ErangaRanasinghe/Solar_LoRa_SHT41_Sensor/govi_v3_SHT41_sensor_kicad.kicad_pcb

## KiCad design govi_v3_SHT41_sensor_kicad.kicad_pcb (2025-12-08)

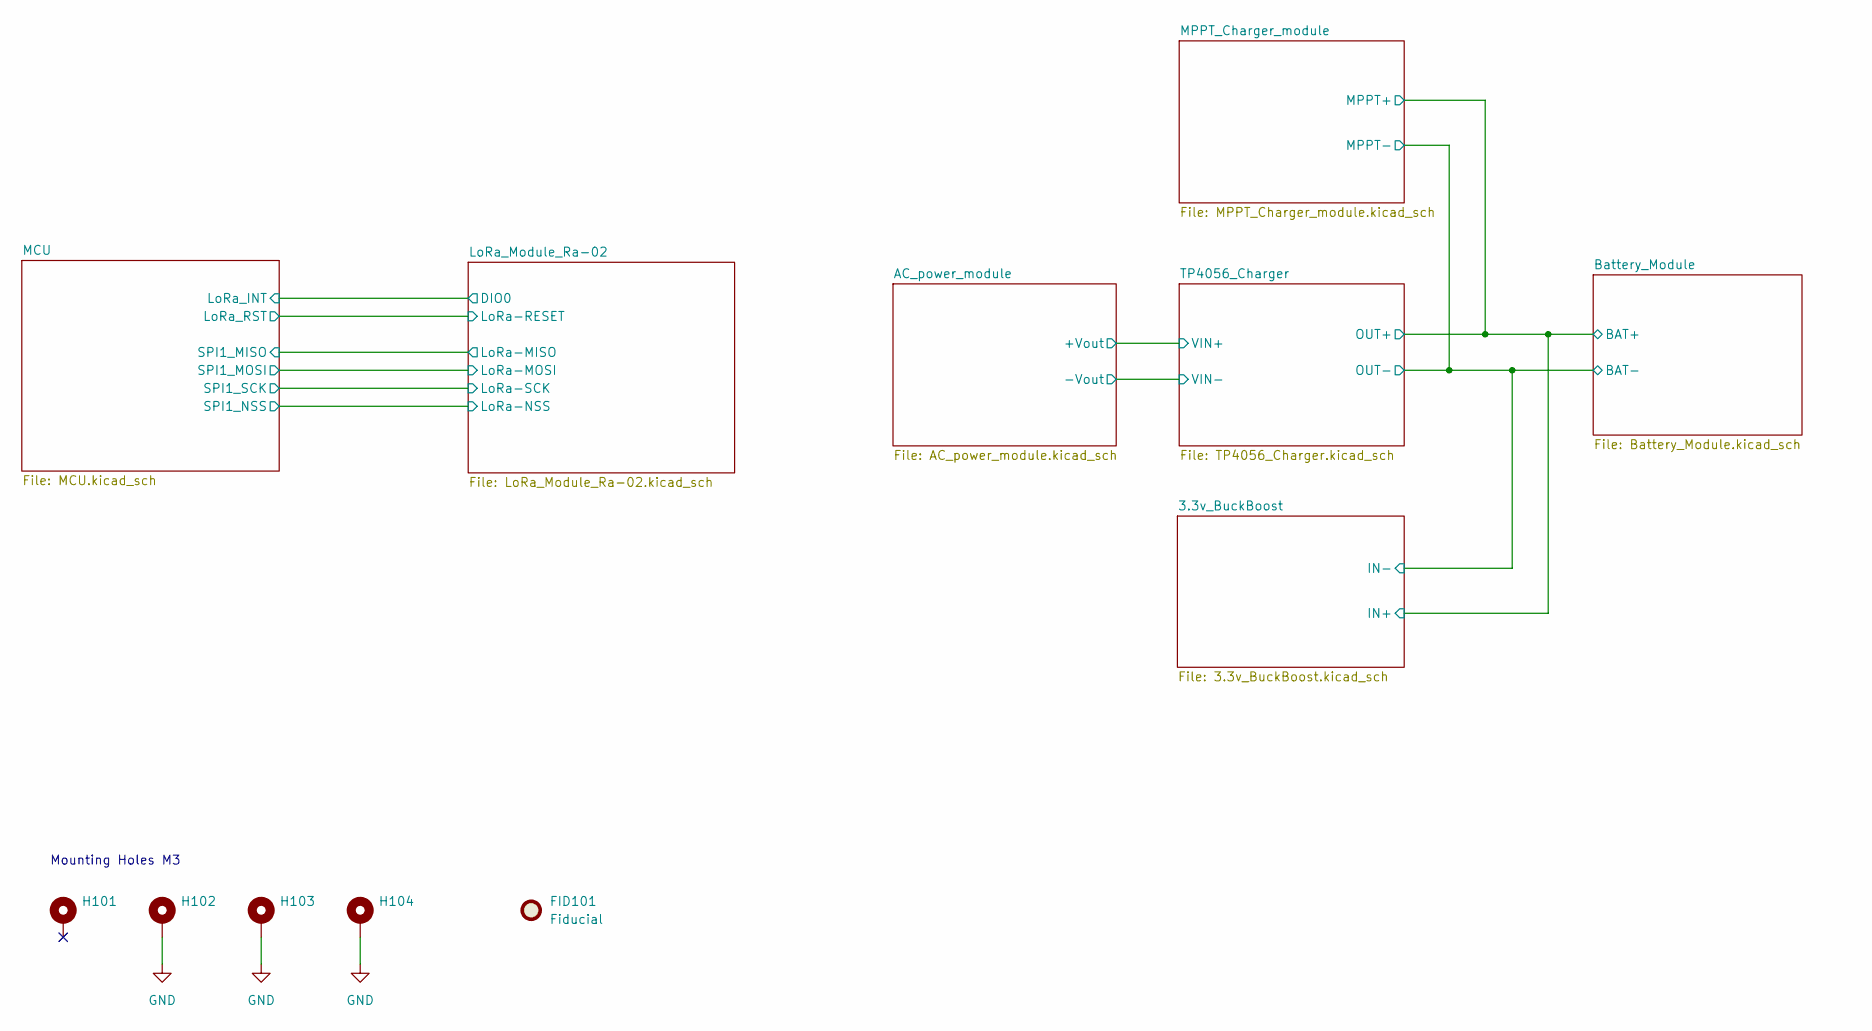
[picture p1: schematic govi_v3_SHT41_sensor_kicad.kicad_sch]

Parts:
FID101: Fiducial; Fiducial_1mm_Mask3mm
H101, H102, H103, H104: MountingHole_Pad; MountingHole_3.2mm_M3_Pad_TopBottom

Connections:
GND: H102.1, H103.1, H104.1; also elsewhere on the board

Notes on the sheet:
Mounting Holes M3

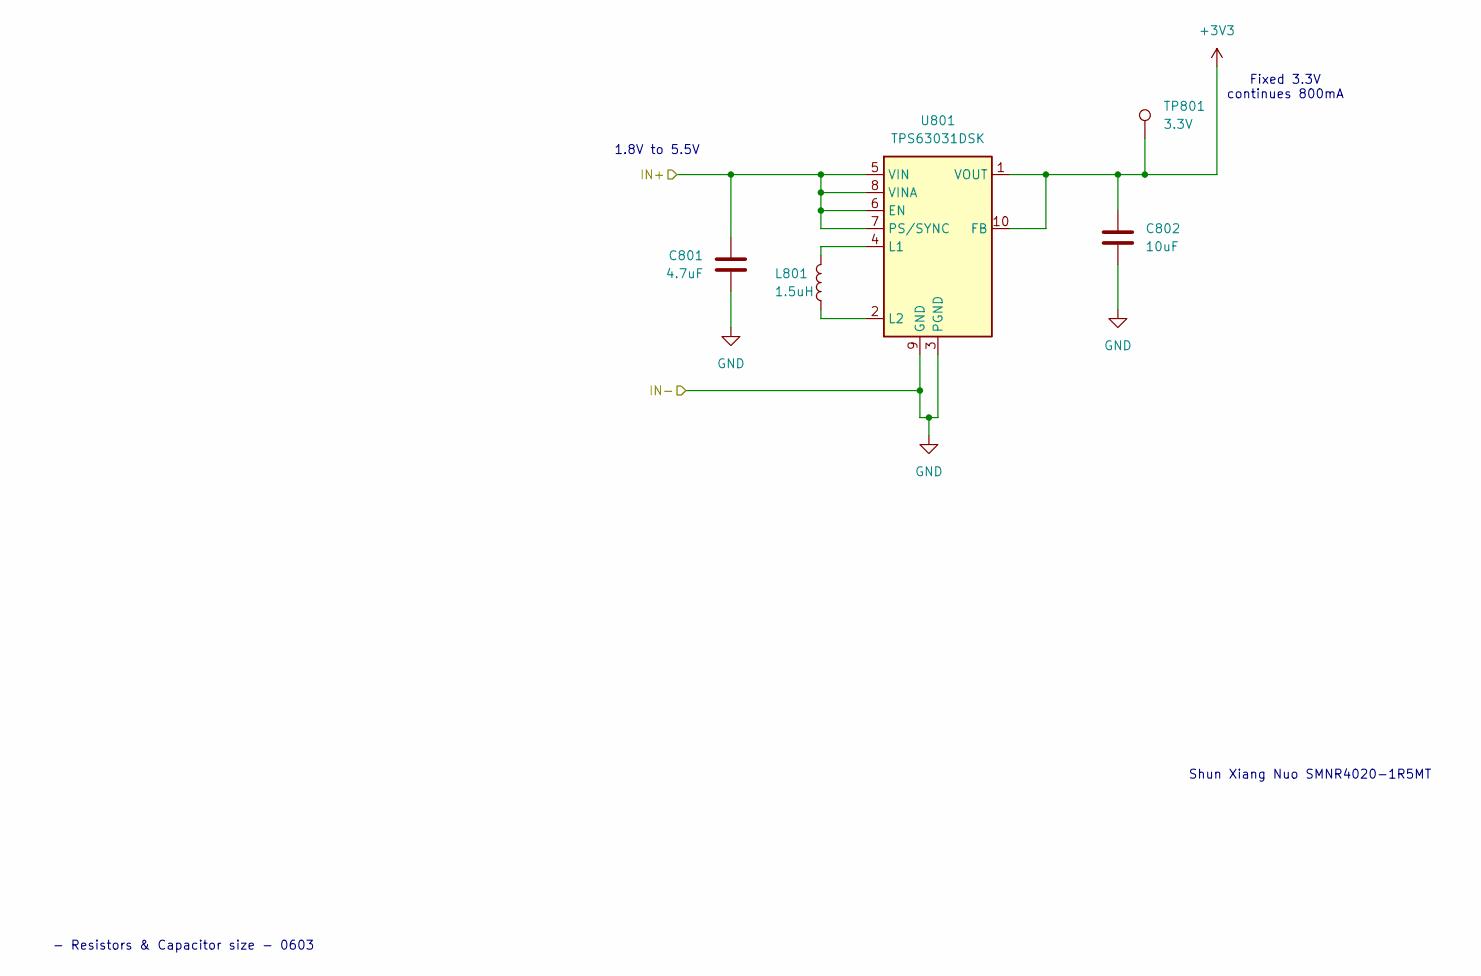
[picture p2: schematic 3.3v_BuckBoost.kicad_sch]

Parts:
C801: 4.7uF; C_0603_1608Metric_Pad1.08x0.95mm_HandSolder
C802: 10uF; C_0603_1608Metric_Pad1.08x0.95mm_HandSolder
L801: 1.5uH; L_Wurth_WE-LQSH-4020
TP801: 3.3V; TestPoint_Pad_D1.0mm
U801: TPS63031DSK; WSON-10-1EP_2.5x2.5mm_P0.5mm_EP1.2x2mm

Connections:
+3V3: C802.1, TP801.1, U801.1 (VOUT), U801.10 (FB); also elsewhere on the board
/3.3v_BuckBoost/IN+: C801.1, U801.5 (VIN), U801.6 (EN), U801.7 (PS/SYNC), U801.8 (VINA); also elsewhere on the board
GND: C801.2, C802.2, U801.3 (PGND), U801.9 (GND), U801.11 (PGND); also elsewhere on the board
unnamed: L801.1, U801.4 (L1)
unnamed: L801.2, U801.2 (L2)

Notes on the sheet:
Shun Xiang Nuo SMNR4020-1R5MT
- Resistors & Capacitor size - 0603
1.8V to 5.5V
Fixed 3.3V continues 800mA

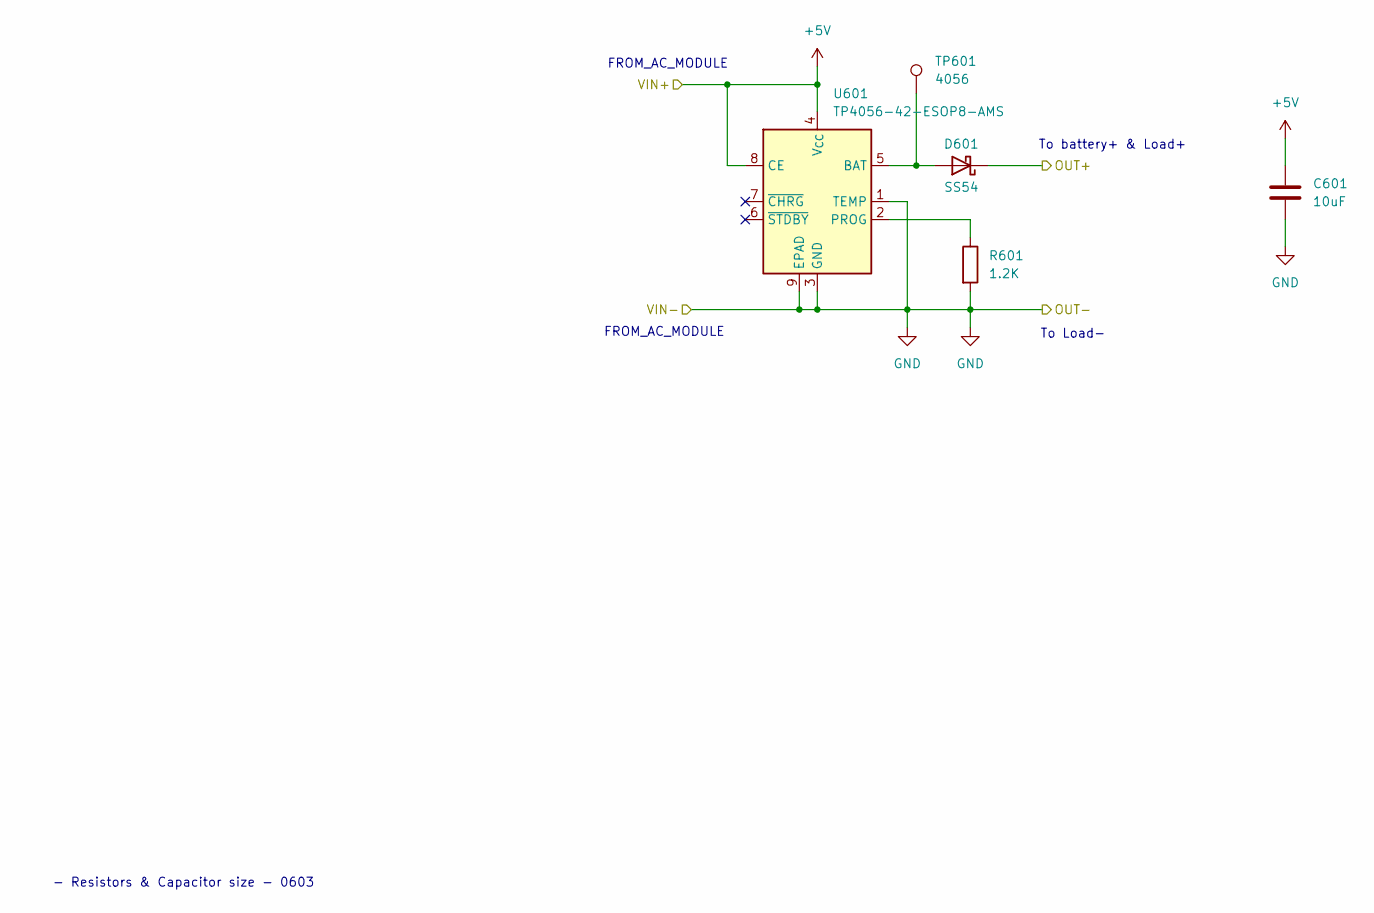
[picture p3: schematic TP4056_Charger.kicad_sch]

Parts:
C601: 10uF; C_0603_1608Metric_Pad1.08x0.95mm_HandSolder
D601: SS54; D_SMA
R601: 1.2K; R_0603_1608Metric_Pad0.98x0.95mm_HandSolder
TP601: 4056; TestPoint_Pad_D1.0mm
U601: TP4056-42-ESOP8-AMS; SOIC-8-1EP_3.9x4.9mm_P1.27mm_EP2.41x3.3mm_ThermalVias

Connections:
+5V: C601.1, U601.4 (V_{CC}), U601.8 (CE); also elsewhere on the board
/3.3v_BuckBoost/IN+: D601.1 (K); also elsewhere on the board
GND: C601.2, R601.2, U601.1 (TEMP), U601.3 (GND), U601.9 (EPAD); also elsewhere on the board
unnamed: D601.2 (A), TP601.1, U601.5 (BAT)
unnamed: R601.1, U601.2 (PROG)

Notes on the sheet:
- Resistors & Capacitor size - 0603
To battery+ & Load+
To Load-
FROM_AC_MODULE

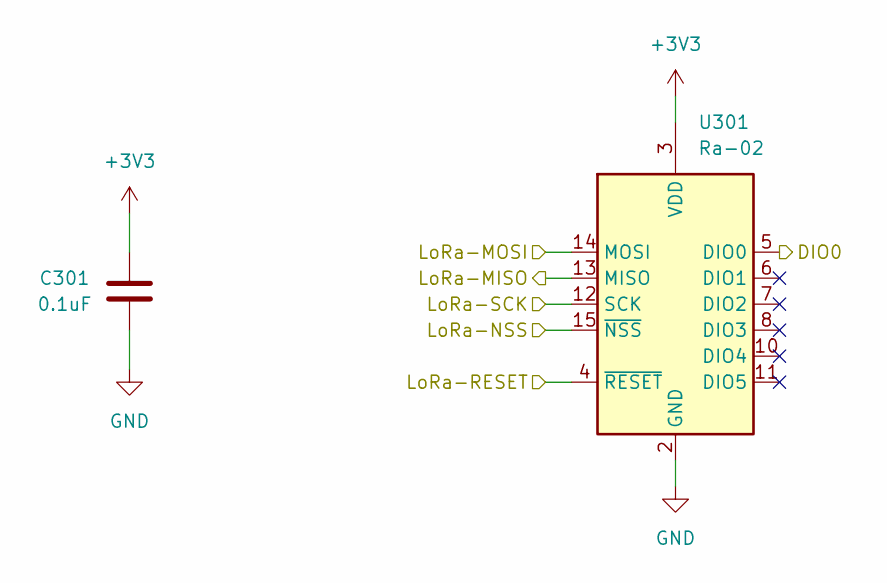
[picture p4: schematic LoRa_Module_Ra-02.kicad_sch]

Parts:
C301: 0.1uF; C_0402_1005Metric_Pad0.74x0.62mm_HandSolder
U301: Ra-02; Ai-Thinker-Ra-01-LoRa

Connections:
+3V3: C301.1, U301.3 (VDD); also elsewhere on the board
/LoRa_Module_Ra-02/LoRa-MISO: U301.13 (MISO); also elsewhere on the board
/LoRa_Module_Ra-02/LoRa-MOSI: U301.14 (MOSI); also elsewhere on the board
/LoRa_Module_Ra-02/LoRa-NSS: U301.15 (~NSS); also elsewhere on the board
/LoRa_Module_Ra-02/LoRa-RESET: U301.4 (~RESET); also elsewhere on the board
/LoRa_Module_Ra-02/LoRa-SCK: U301.12 (SCK); also elsewhere on the board
/MCU/LoRa_INT: U301.5 (DIO0); also elsewhere on the board
GND: C301.2, U301.1 (GND), U301.2 (GND), U301.9 (GND), U301.16 (GND); also elsewhere on the board

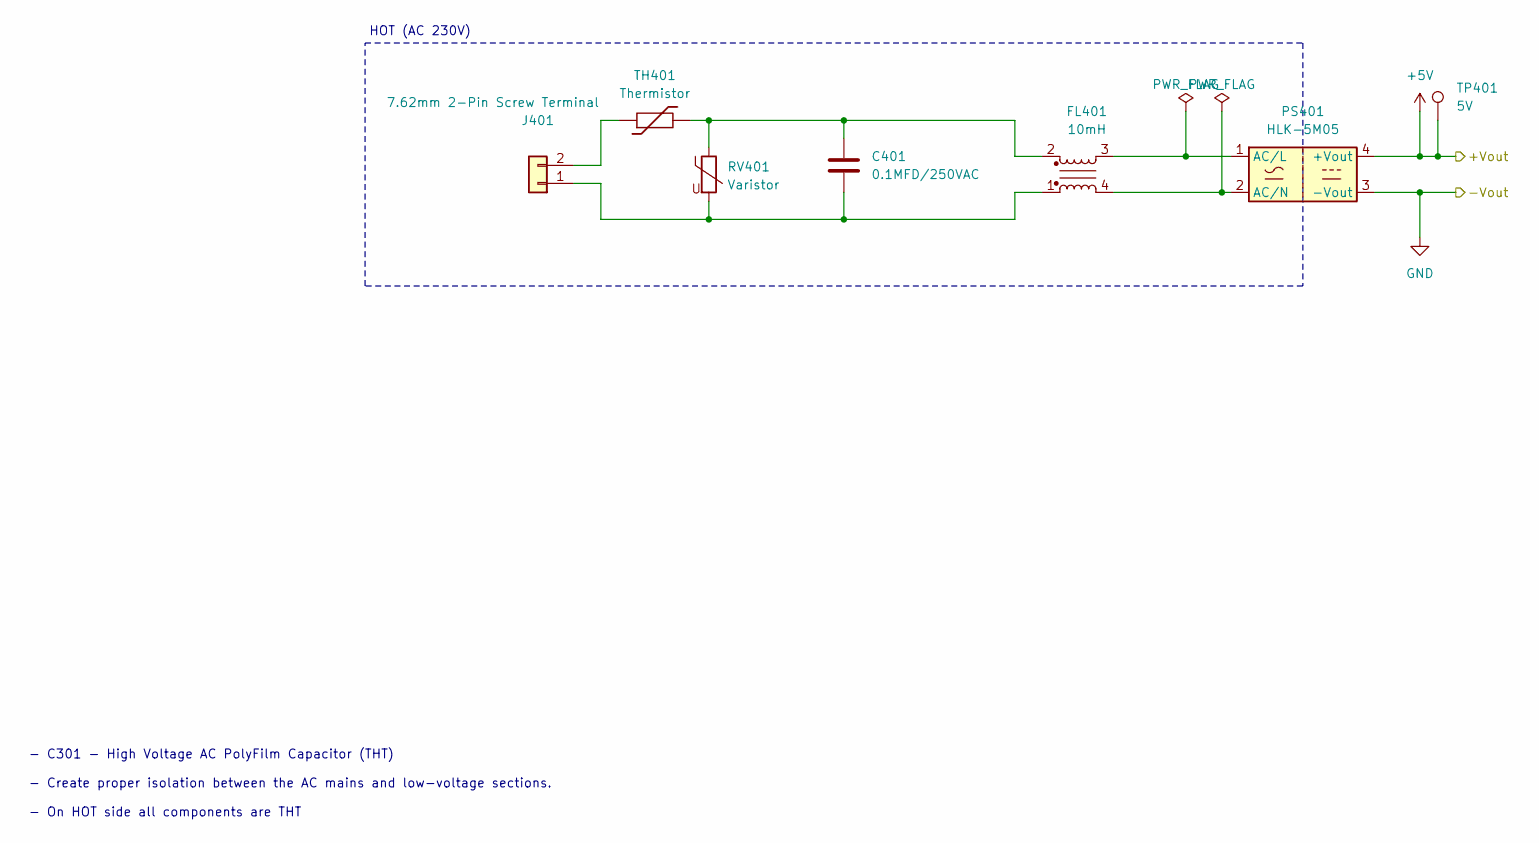
[picture p5: schematic AC_power_module.kicad_sch]

Parts:
C401: 0.1MFD/250VAC; C_Rect_L11.5mm_W5.0mm_P10.00mm_MKT
FL401: 10mH; B82730U3451A020-ferrite-core-inductor
J401: 7.62mm 2-Pin Screw Terminal; P=7.62mm Barrier Terminal Blocks azend
PS401: HLK-5M05; HLK5M05
RV401: Varistor; RV_Disc_D12mm_W5.1mm_P7.5mm
TH401: Thermistor; B57236S0250M000-Thermister
TP401: 5V; TestPoint_Pad_D1.0mm

Connections:
+5V: PS401.4 (+Vout), TP401.1; also elsewhere on the board
GND: PS401.3 (-Vout); also elsewhere on the board
unnamed: C401.1, FL401.2, RV401.1, TH401.2
unnamed: C401.2, FL401.1, J401.1, RV401.2
unnamed: J401.2, TH401.1
unnamed: FL401.3, PS401.1 (AC/L)
unnamed: FL401.4, PS401.2 (AC/N)

Notes on the sheet:
HOT (AC 230V)
- C301 - High Voltage AC PolyFilm Capacitor (THT) - Create proper isolation between the AC mains and low-voltage sections. - On HOT side all components are THT

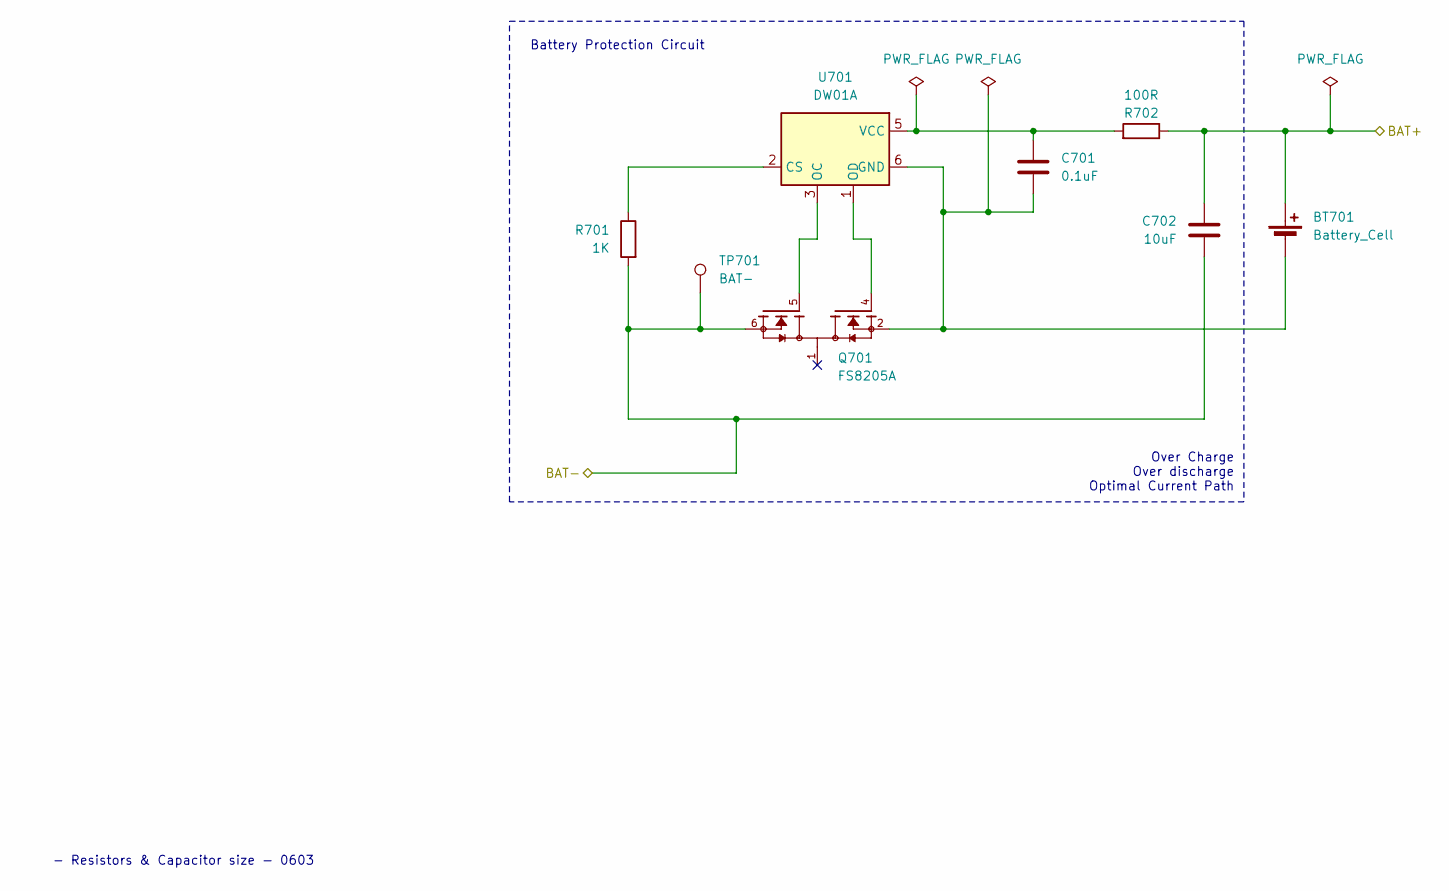
[picture p6: schematic Battery_Module.kicad_sch]

Parts:
BT701: Battery_Cell; BAT_1042P
C701: 0.1uF; C_0603_1608Metric_Pad1.08x0.95mm_HandSolder
C702: 10uF; C_0603_1608Metric_Pad1.08x0.95mm_HandSolder
Q701: FS8205A; SOP65P640X120-8N; PARTREV 1.7
R701: 1K; R_0603_1608Metric_Pad0.98x0.95mm_HandSolder
R702: 100R; R_0603_1608Metric_Pad0.98x0.95mm_HandSolder
TP701: BAT-; TestPoint_Pad_D1.0mm
U701: DW01A; SOT-23-6

Connections:
/3.3v_BuckBoost/IN+: BT701.1 (+), C702.1, R702.1; also elsewhere on the board
GND: C702.2, Q701.6, Q701.7, R701.2, TP701.1; also elsewhere on the board
unnamed: BT701.2 (-), C701.2, Q701.2, Q701.3, U701.6 (GND)
unnamed: R701.1, U701.2 (CS)
unnamed: Q701.5, U701.3 (OC)
unnamed: Q701.4, U701.1 (OD)
unnamed: C701.1, R702.2, U701.5 (VCC)

Notes on the sheet:
Over Charge Over discharge Optimal Current Path
- Resistors & Capacitor size - 0603
Battery Protection Circuit

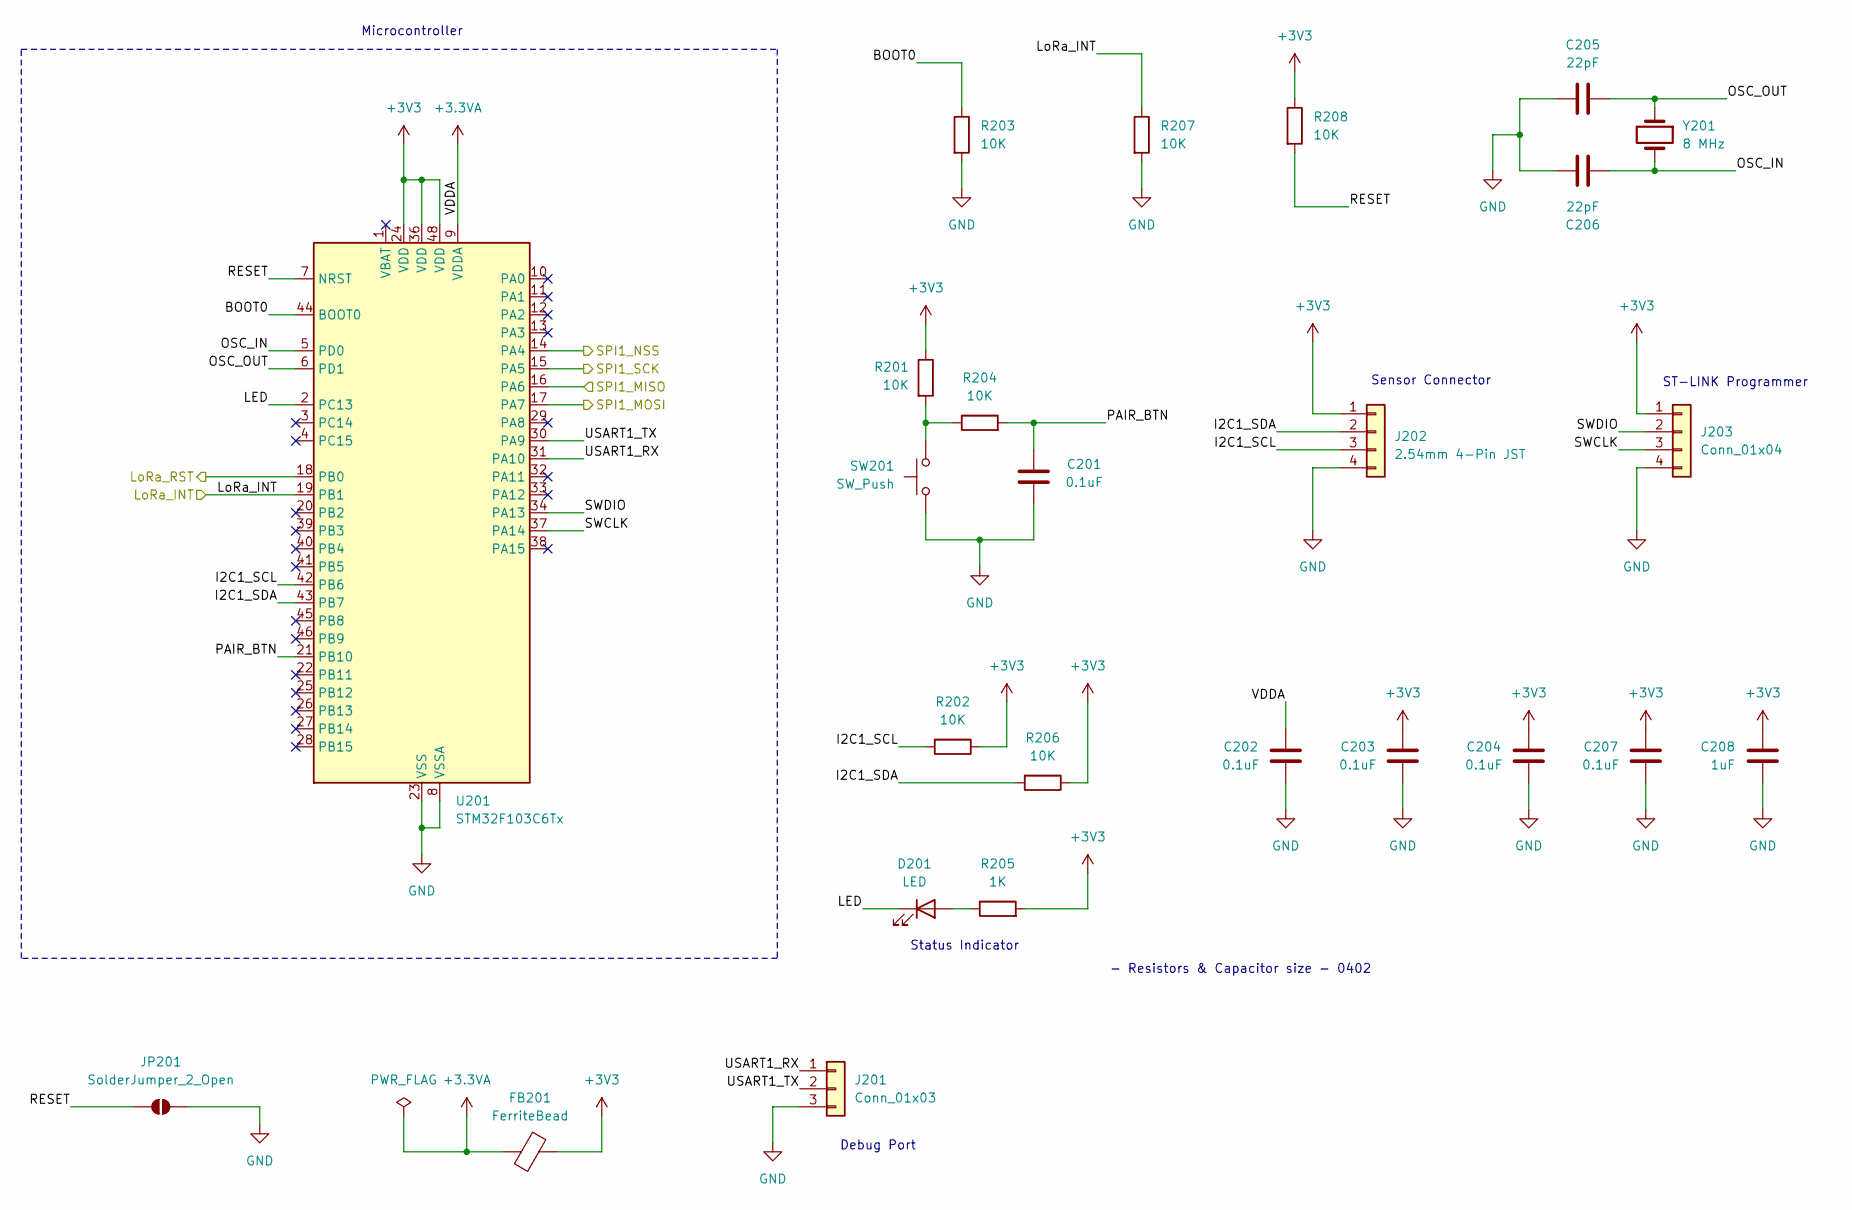
[picture p7: schematic MCU.kicad_sch]

Parts:
C201, C202, C203, C204, C207: 0.1uF; C_0402_1005Metric_Pad0.74x0.62mm_HandSolder
C205, C206: 22pF; C_0402_1005Metric_Pad0.74x0.62mm_HandSolder
C208: 1uF; C_0402_1005Metric_Pad0.74x0.62mm_HandSolder
D201: LED; LED_D3.0mm
FB201: FerriteBead; R_0402_1005Metric_Pad0.72x0.64mm_HandSolder
J201: Conn_01x03; PinHeader_1x03_P2.54mm_Vertical
J202: 2.54mm 4-Pin JST; JST_EH_B4B-EH-A_1x04_P2.50mm_Vertical
J203: Conn_01x04; PinHeader_1x04_P2.54mm_Vertical
JP201: SolderJumper_2_Open; SolderJumper-2_P1.3mm_Open_RoundedPad1.0x1.5mm
R201, R202, R203, R204, R206, R207, R208: 10K; R_0402_1005Metric_Pad0.72x0.64mm_HandSolder
R205: 1K; R_0402_1005Metric_Pad0.72x0.64mm_HandSolder
SW201: SW_Push; PinHeader_1x02_P2.54mm_Vertical
U201: STM32F103C6Tx; LQFP-48_7x7mm_P0.5mm
Y201: 8 MHz; Crystal_HC49-4H_Vertical

Connections:
+3.3VA: C202.1, FB201.2, U201.9 (VDDA)
+3V3: C203.1, C204.1, C207.1, C208.1, FB201.1, J202.1, J203.1, R201.1, R202.1, R205.2, R206.1, R208.1, U201.24 (VDD), U201.36 (VDD), U201.48 (VDD); also elsewhere on the board
/LoRa_Module_Ra-02/LoRa-MISO: U201.16 (PA6); also elsewhere on the board
/LoRa_Module_Ra-02/LoRa-MOSI: U201.17 (PA7); also elsewhere on the board
/LoRa_Module_Ra-02/LoRa-NSS: U201.14 (PA4); also elsewhere on the board
/LoRa_Module_Ra-02/LoRa-RESET: U201.18 (PB0); also elsewhere on the board
/LoRa_Module_Ra-02/LoRa-SCK: U201.15 (PA5); also elsewhere on the board
/MCU/BOOT0: R203.1, U201.44 (BOOT0)
/MCU/I2C1_SCL: J202.3, R202.2, U201.42 (PB6)
/MCU/I2C1_SDA: J202.2, R206.2, U201.43 (PB7)
/MCU/LED: D201.1 (K), U201.2 (PC13)
/MCU/LoRa_INT: R207.1, U201.19 (PB1); also elsewhere on the board
/MCU/OSC_IN: C206.1, U201.5 (PD0), Y201.2
/MCU/OSC_OUT: C205.1, U201.6 (PD1), Y201.1
/MCU/PAIR_BTN: C201.1, R204.2, U201.21 (PB10)
/MCU/RESET: JP201.1 (A), R208.2, U201.7 (NRST)
/MCU/SWCLK: J203.3, U201.37 (PA14)
/MCU/SWDIO: J203.2, U201.34 (PA13)
/MCU/USART1_RX: J201.1, U201.31 (PA10)
/MCU/USART1_TX: J201.2, U201.30 (PA9)
GND: C201.2, C202.2, C203.2, C204.2, C205.2, C206.2, C207.2, C208.2, J201.3, J202.4, J203.4, JP201.2 (B), R203.2, R207.2, SW201.1, U201.8 (VSSA), U201.23 (VSS), U201.35 (VSS), U201.47 (VSS); also elsewhere on the board
unnamed: D201.2 (A), R205.1
unnamed: R201.2, R204.1, SW201.2

Notes on the sheet:
Status Indicator
Debug Port
Sensor Connector
- Resistors & Capacitor size - 0402
ST-LINK Programmer
Microcontroller

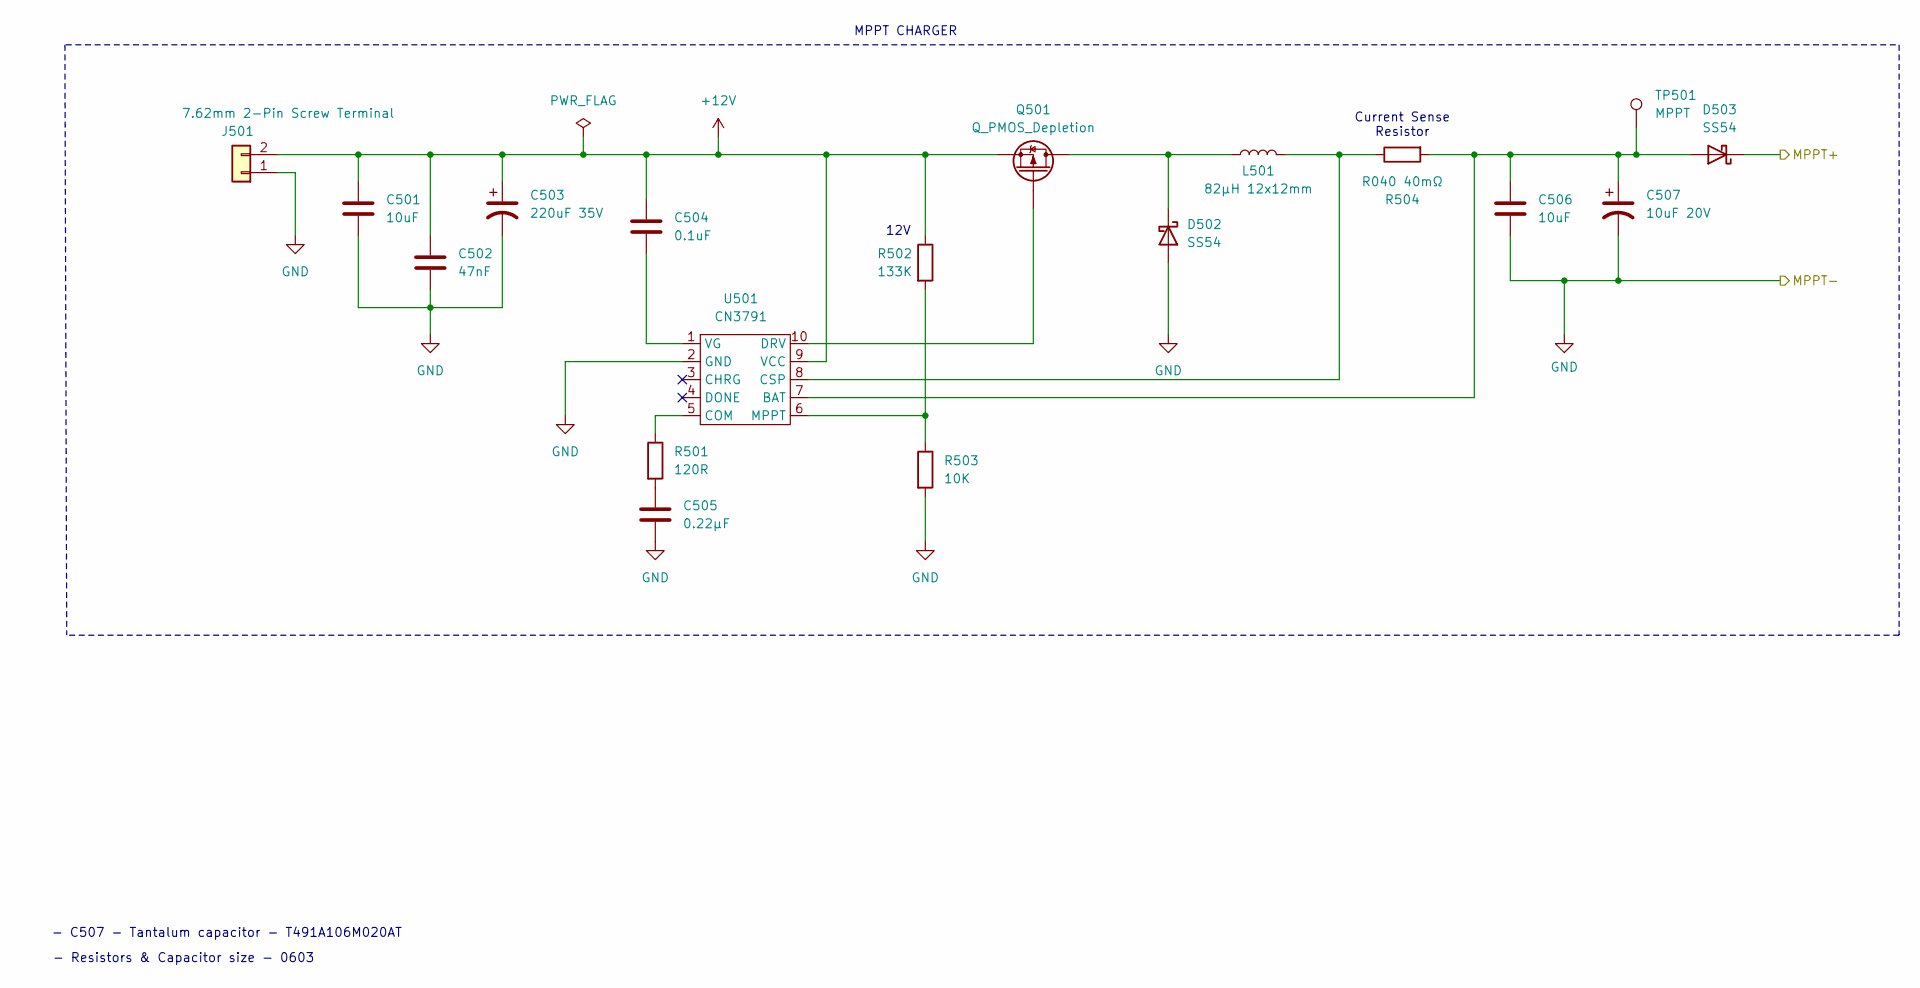
[picture p8: schematic MPPT_Charger_module.kicad_sch]

Parts:
C501, C506: 10uF; C_0603_1608Metric_Pad1.08x0.95mm_HandSolder
C502: 47nF; C_0603_1608Metric_Pad1.08x0.95mm_HandSolder
C503: 220uF 35V; CP_Elec_6.3x7.7
C504: 0.1uF; C_0603_1608Metric_Pad1.08x0.95mm_HandSolder
C505: 0.22µF; C_0603_1608Metric_Pad1.08x0.95mm_HandSolder
C507: 10uF 20V; CP_EIA-3216-18_Kemet-A_HandSolder
D502, D503: SS54; D_SMA
J501: 7.62mm 2-Pin Screw Terminal; P=7.62mm Barrier Terminal Blocks azend
L501: 82µH 12x12mm; L_12x12mm_H4.5mm
Q501: Q_PMOS_Depletion; TO-252-2
R501: 120R; R_0603_1608Metric_Pad0.98x0.95mm_HandSolder
R502: 133K; R_0603_1608Metric_Pad0.98x0.95mm_HandSolder
R503: 10K; R_0603_1608Metric_Pad0.98x0.95mm_HandSolder
R504: R040 40mΩ; R_2512_6332Metric_Pad1.40x3.35mm_HandSolder
TP501: MPPT; TestPoint_Pad_D1.0mm
U501: CN3791; SSOP-10_3.9x4.9mm_P1.00mm

Connections:
+12V: C501.1, C502.1, C503.1, C504.1, J501.2, Q501.3 (S), R502.1, U501.9 (VCC)
/3.3v_BuckBoost/IN+: D503.1 (K); also elsewhere on the board
GND: C501.2, C502.2, C503.2, C505.2, C506.2, C507.2, D502.2 (A), J501.1, R503.2, U501.2 (GND); also elsewhere on the board
unnamed: C505.1, R501.2
unnamed: D502.1 (K), L501.1, Q501.2 (D)
unnamed: C506.1, C507.1, D503.2 (A), R504.2, TP501.1, U501.7 (BAT)
unnamed: Q501.1 (G), U501.10 (DRV)
unnamed: R501.1, U501.5 (COM)
unnamed: L501.2, R504.1, U501.8 (CSP)
unnamed: R502.2, R503.1, U501.6 (MPPT)
unnamed: C504.2, U501.1 (VG)

Notes on the sheet:
Current Sense Resistor
12V
- C507 - Tantalum capacitor - T491A106M020AT
- Resistors & Capacitor size - 0603
MPPT CHARGER

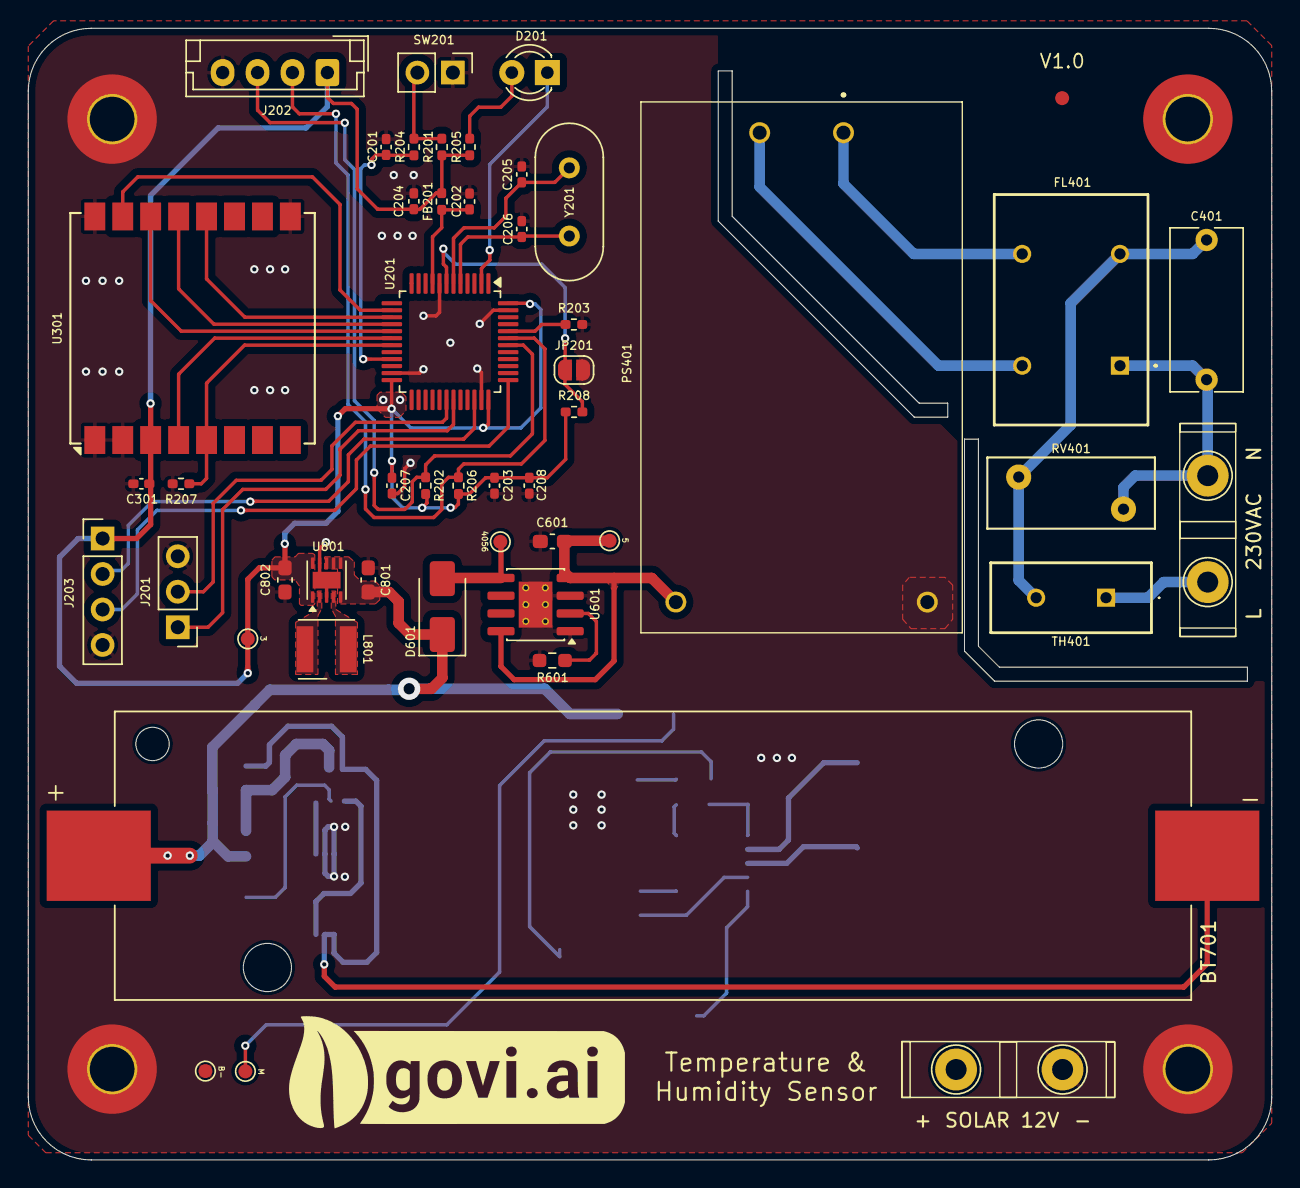
[picture p9: board govi_v3_SHT41_sensor_kicad.kicad_pcb from above]

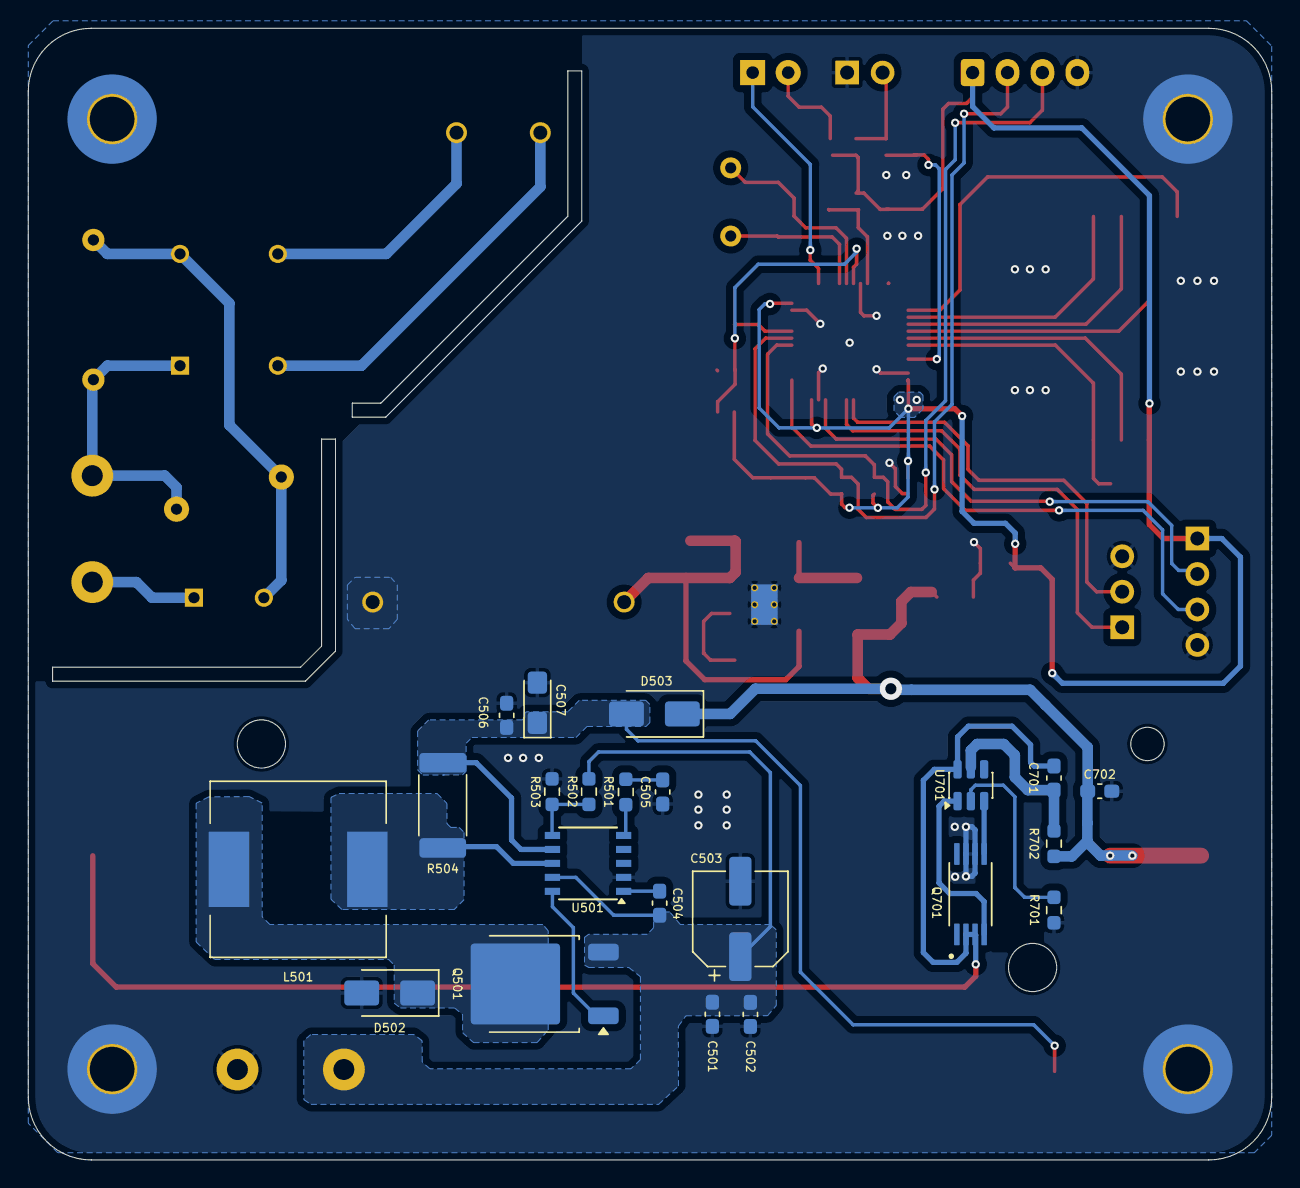
[picture p10: board govi_v3_SHT41_sensor_kicad.kicad_pcb from below]

Board: 2 copper layers, 89.0 x 81.0 mm, 75 parts (22 on the bottom side), 48 nets.
