ErangaRanasinghe/Solar_LoRa_SHT41_Sensor/SHT41-SensorBoard/SHT41-SensorBoard.kicad_pcb

## KiCad design SHT41-SensorBoard/SHT41-SensorBoard.kicad_pcb (2025-11-30)

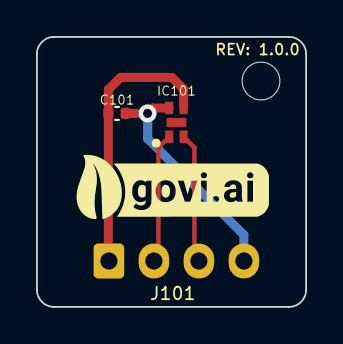
[picture p11: board SHT41-SensorBoard.kicad_pcb from above]

Board: 2 copper layers, 15.0 x 15.0 mm, 5 parts (0 on the bottom side), 4 nets.

Parts:
C101: C; C_0402_1005Metric
G1: GOVI.AI-LOGO-FRONT; govi-ai-logo-front-for-sensor
H101: M2.5; MountingHole_2.1mm
IC101: SHT41A-AD1B-R2; SON80P150X150X59-5N
J101: 2.54mm 4-Pin JST; JST_EH_B4B-EH-A_1x04_P2.50mm_Vertical

Connections:
+3V3: C101.1, IC101.3 (VDD), J101.1
/I2C-SCL: IC101.2 (SCL), J101.3
/I2C-SDA: IC101.1 (SDA), J101.2
GND: C101.2, IC101.4 (VSS), J101.4
