ErangaRanasinghe/Solar_LoRa_SHT41_Sensor/(commit log)

2025-11-30 "initial commit schematic design"
    [3.3v_Converter.kicad_sch, AC_power_module.kicad_sch, Battery.kicad_sch, Battery_Module.kicad_sch, Charger_module.kicad_sch, LoRa_Module_Ra-02.kicad_sch, MCU.kicad_sch, MPPT_Charger_module.kicad_sch]
2025-12-02 "3.3V buck boost converter added. few footprints added"
    [3.3v_Converter.kicad_sch, Battery_Module.kicad_sch, LoRa_Module_Ra-02.kicad_sch]
2025-12-02 "Assign Footprints Done"
    [3.3v_BuckBoost.kicad_sch, AC_power_module.kicad_sch, Battery_Module.kicad_sch, LoRa_Module_Ra-02.kicad_sch, MCU.kicad_sch, MPPT_Charger_module.kicad_sch, TP4056_Charger.kicad_sch, govi_v3_SHT41_sensor_kicad.kicad_sch]
2025-12-02 "Some Component values were changed in MPPT sheet"
    [MPPT_Charger_module.kicad_sch, govi_v3_SHT41_sensor_kicad.kicad_sch]
2025-12-03 "I2c Pin change. PB6:SCL1 , PB7:SDA1"
    [AC_power_module.kicad_sch, MCU.kicad_sch, govi_v3_SHT41_sensor_kicad.kicad_pcb]
2025-12-03 "Debug port added in schematic"
    [MCU.kicad_sch]
2025-12-04 "PCB front Layer Component assembly done"
    [3.3v_BuckBoost.kicad_sch, AC_power_module.kicad_sch, Battery_Module.kicad_sch, MCU.kicad_sch, MPPT_Charger_module.kicad_sch, TP4056_Charger.kicad_sch, govi_v3_SHT41_sensor_kicad.kicad_pcb]
2025-12-06 "Working on Routing MCU"
    [MPPT_Charger_module.kicad_sch, govi_v3_SHT41_sensor_kicad.kicad_pcb]
2025-12-06 "Before changing the orientation of the LoRa module. removing existing LoRa module routing."
    [3.3v_BuckBoost.kicad_sch, Battery_Module.kicad_sch, MPPT_Charger_module.kicad_sch, TP4056_Charger.kicad_sch, govi_v3_SHT41_sensor_kicad.kicad_pcb, govi_v3_SHT41_sensor_kicad.kicad_sch]
2025-12-08 "Routing done. DRC pending"
    [AC_power_module.kicad_sch, MPPT_Charger_module.kicad_sch, govi_v3_SHT41_sensor_kicad.kicad_pcb]
